Riggstadt/PROIECT_1_ETTI/Tema_N18.pdf

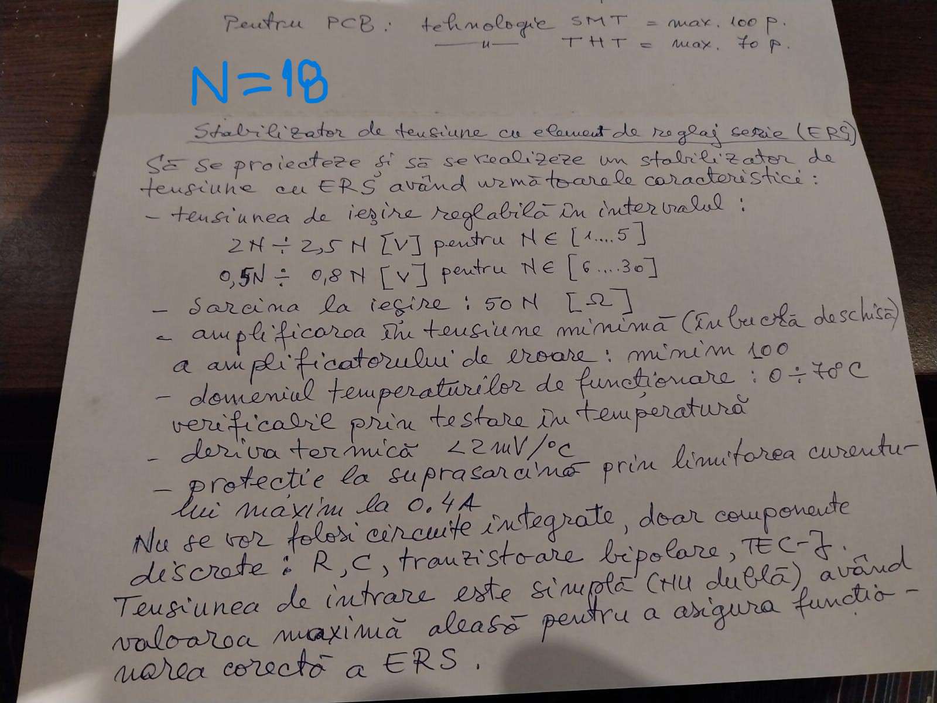
[picture p4: page 1]
