Riggstadt/PROIECT_1_ETTI/DATASHEETS/nails-emoji.gif

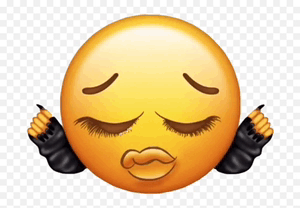
DATASHEETS/nails-emoji.gif
