Riggstadt/PROIECT_1_ETTI/SCHEMATICS/REG_PCB_BRD.jpg

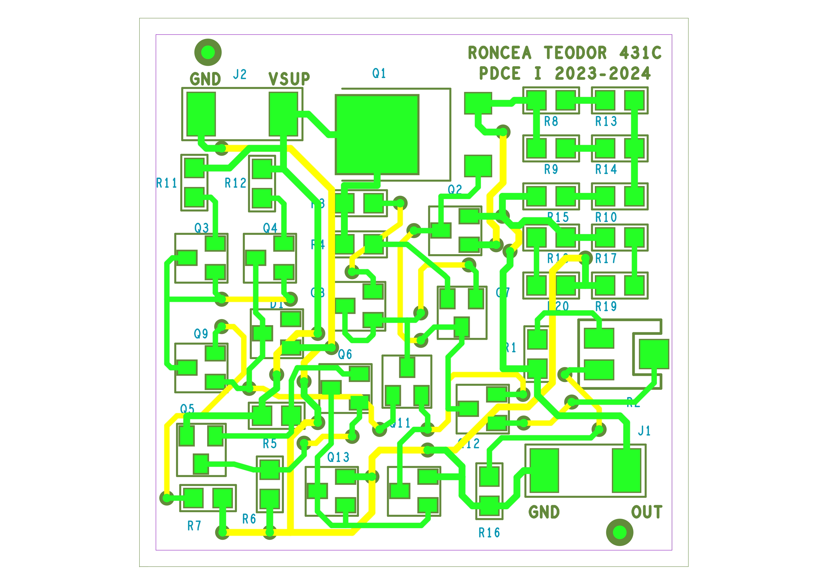
SCHEMATICS/REG_PCB_BRD.jpg
