Riggstadt/PROIECT_1_ETTI/SCHEMATICS/SCHEMA_ORCAD.jpg

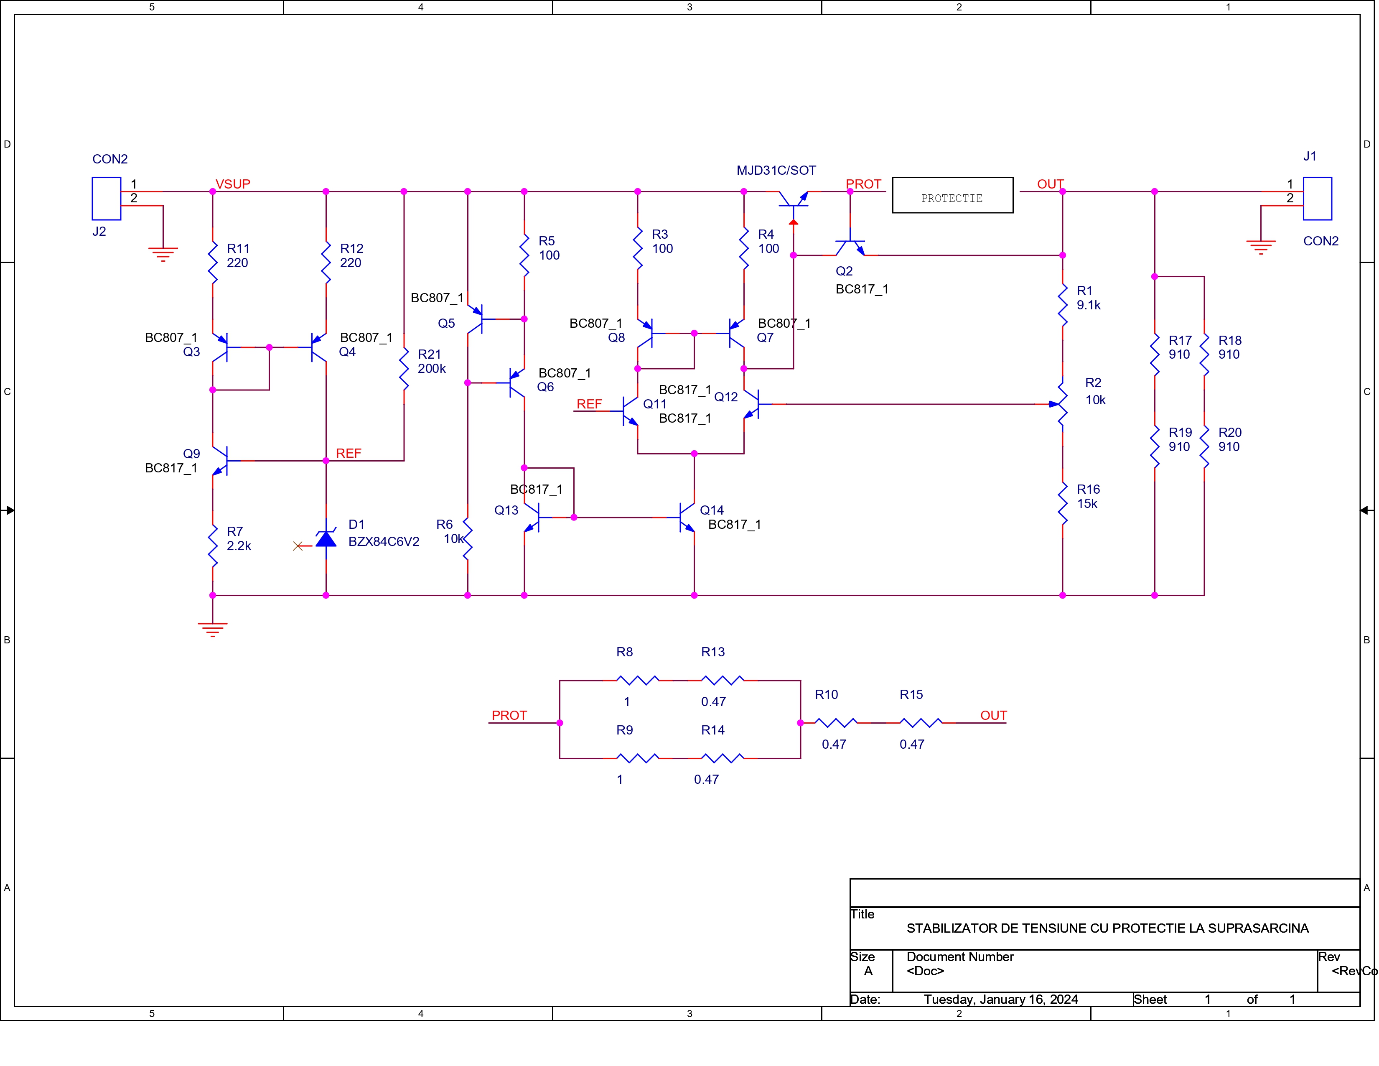
SCHEMATICS/SCHEMA_ORCAD.jpg
