Riggstadt/PROIECT_1_ETTI/SIMULATIONS/LOAD_REGULATION.jpg

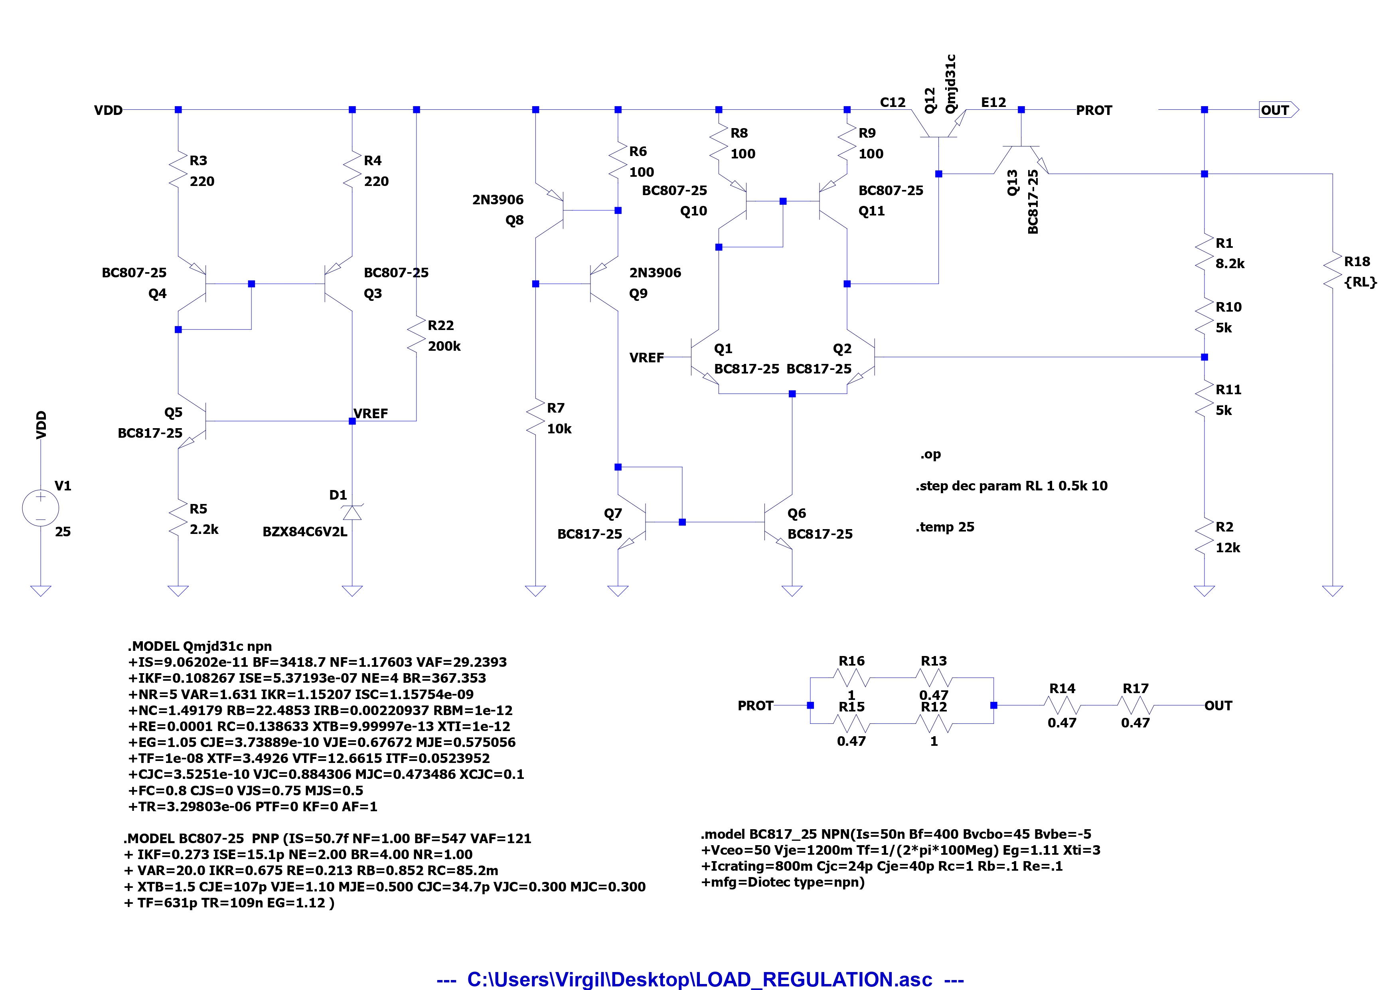
SIMULATIONS/LOAD_REGULATION.jpg
