Riggstadt/PROIECT_1_ETTI/SIMULATIONS/OPEN_LOOP.jpg

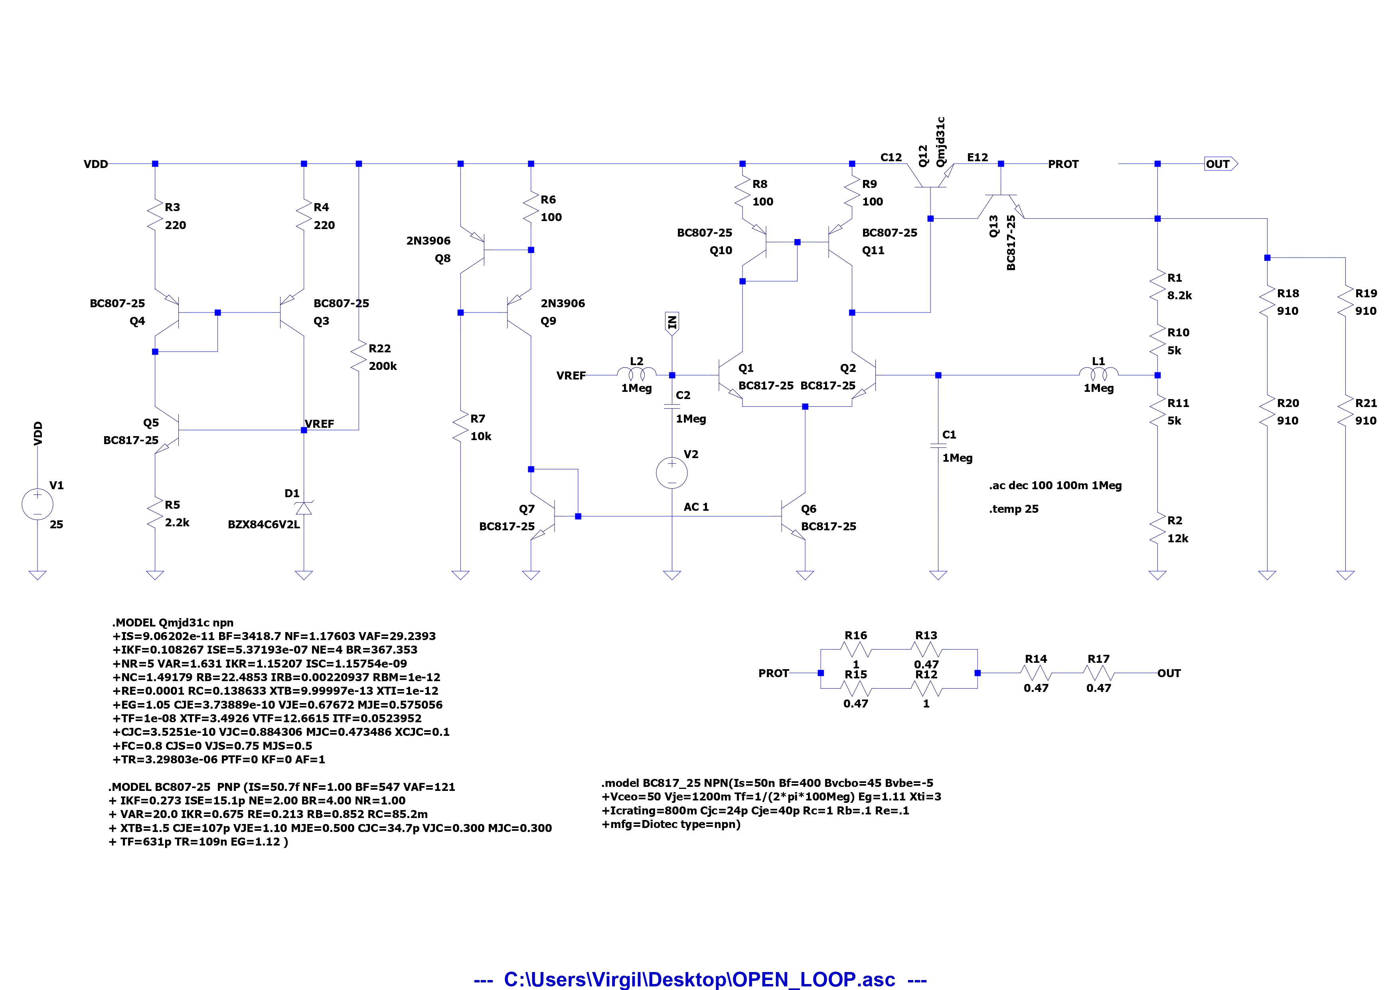
SIMULATIONS/OPEN_LOOP.jpg
