Riggstadt/PROIECT_1_ETTI/SIMULATIONS/RRR.jpg

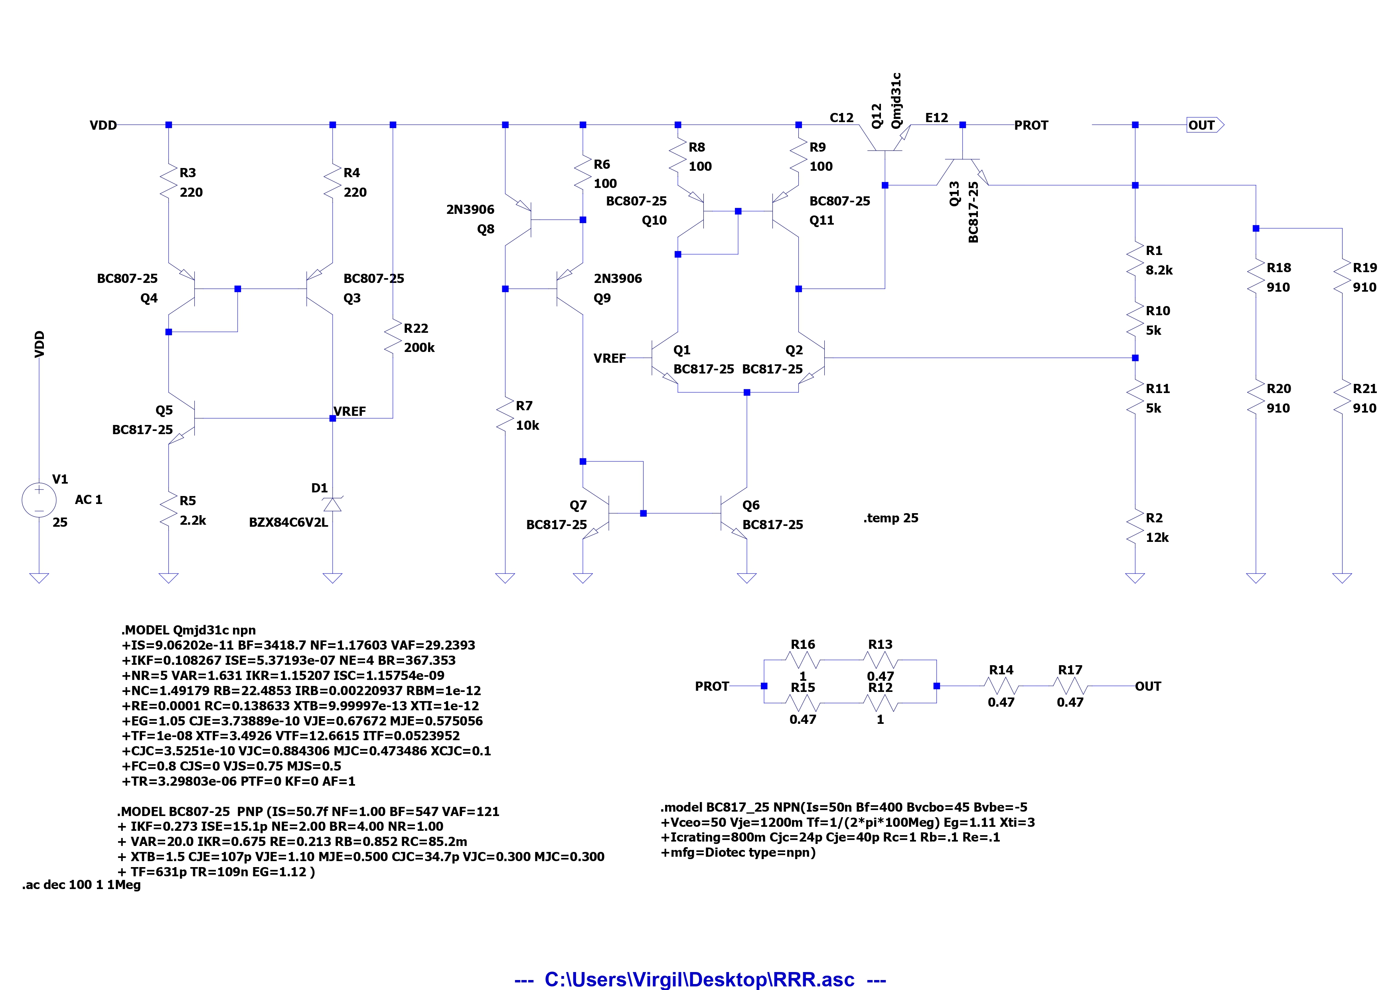
SIMULATIONS/RRR.jpg
