Riggstadt/PROIECT_1_ETTI/SIMULATIONS/LDO_OP.asc

D1: zener; BZX84C6V2L
Q1: npn; BC817-25
Q2: npn; BC817-25
Q3: pnp; BC807-25
Q4: pnp; BC807-25
Q5: pnp; BC807-25
Q6: npn; BC817-25
Q7: npn; BC817-25
Q8: npn; BC817-25
Q9: pnp; BC807-25
Q10: pnp; 2N3906
Q11: pnp; 2N3906
Q12: npn; Qmjd31c
Q13: npn; BC817-25
R1: res; 100
R2: res; 8.2k
R3: res; 12k
R4: res; 220
R5: res; 220
R6: res; 2.2k
R7: res; 100
R8: res; 10k
R9: res; 100
R10: res; 1
R11: res; {(1-p)*10k}
R12: res; {p*10k}
R13: res; 0.47
R14: res; 0.47
R15: res; 0.47
R16: res; 1
R17: res; 0.47
R18: res; 910
R19: res; 200k
R20: res; 910
R21: res; 910
R22: res; 910
V1: voltage; 25
Named nets: 0, VREF, OUT, C12, E12, PROT, VDD
.step param p 0.1 0.99 0.1
.model BC817_25 NPN(Is=50n Bf=400 Bvcbo=45 Bvbe=-5
+Vceo=50 Vje=1200m Tf=1/(2*pi*100Meg) Eg=1.11 Xti=3
+Icrating=800m Cjc=24p Cje=40p Rc=1 Rb=.1 Re=.1
+mfg=Diotec type=npn)
.MODEL Qmjd31c npn
+IS=9.06202e-11 BF=3418.7 NF=1.17603 VAF=29.2393
+IKF=0.108267 ISE=5.37193e-07 NE=4 BR=367.353
+NR=5 VAR=1.631 IKR=1.15207 ISC=1.15754e-09
+NC=1.49179 RB=22.4853 IRB=0.00220937 RBM=1e-12
+RE=0.0001 RC=0.138633 XTB=9.99997e-13 XTI=1e-12
+EG=1.05 CJE=3.73889e-10 VJE=0.67672 MJE=0.575056
+TF=1e-08 XTF=3.4926 VTF=12.6615 ITF=0.0523952
+CJC=3.5251e-10 VJC=0.884306 MJC=0.473486 XCJC=0.1
+FC=0.8 CJS=0 VJS=0.75 MJS=0.5
+TR=3.29803e-06 PTF=0 KF=0 AF=1
.dc V1 0 25 0.01
.MODEL BC807-25  PNP (IS=50.7f NF=1.00 BF=547 VAF=121
+ IKF=0.273 ISE=15.1p NE=2.00 BR=4.00 NR=1.00
+ VAR=20.0 IKR=0.675 RE=0.213 RB=0.852 RC=85.2m
+ XTB=1.5 CJE=107p VJE=1.10 MJE=0.500 CJC=34.7p VJC=0.300 MJC=0.300 
+ TF=631p TR=109n EG=1.12 )
.temp 25
