Riggstadt/PROIECT_1_ETTI/(list of files, drawings)

Other design files:
SCHEMATICS/PSF.DSN
SCHEMATICS/PSF.opj
SCHEMATICS/REG_PCB.DSN
SCHEMATICS/REG_PCB.opj
