Riggstadt/PROIECT_1_ETTI/SIMULATIONS/SC_FAILURE.jpg

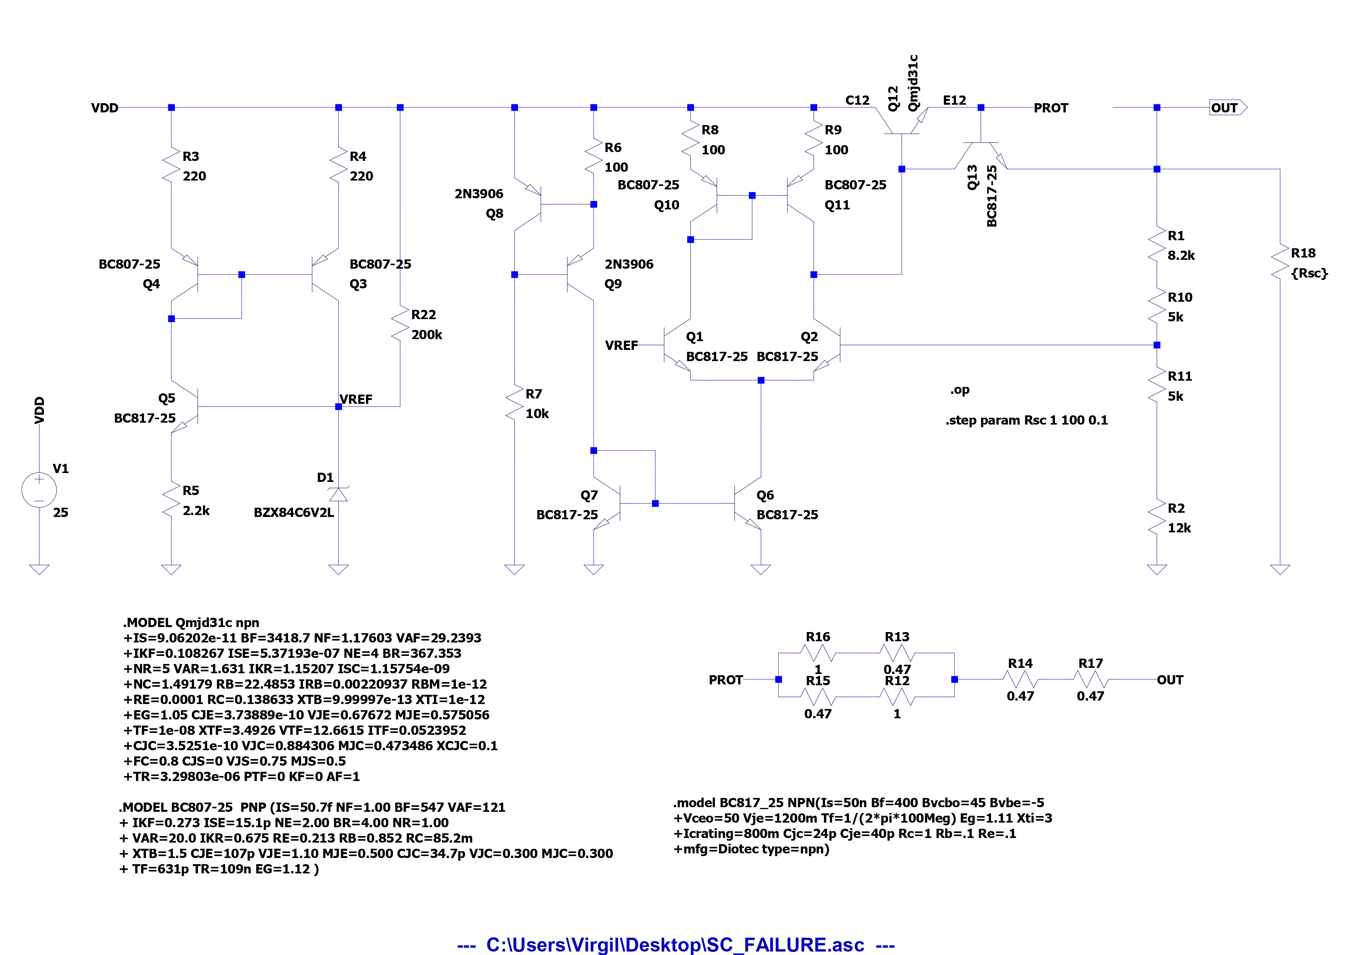
SIMULATIONS/SC_FAILURE.jpg
